Benicio54/Tucuman-respira/Informe_Técnico_Documentación/figuras/fig_22.jpeg

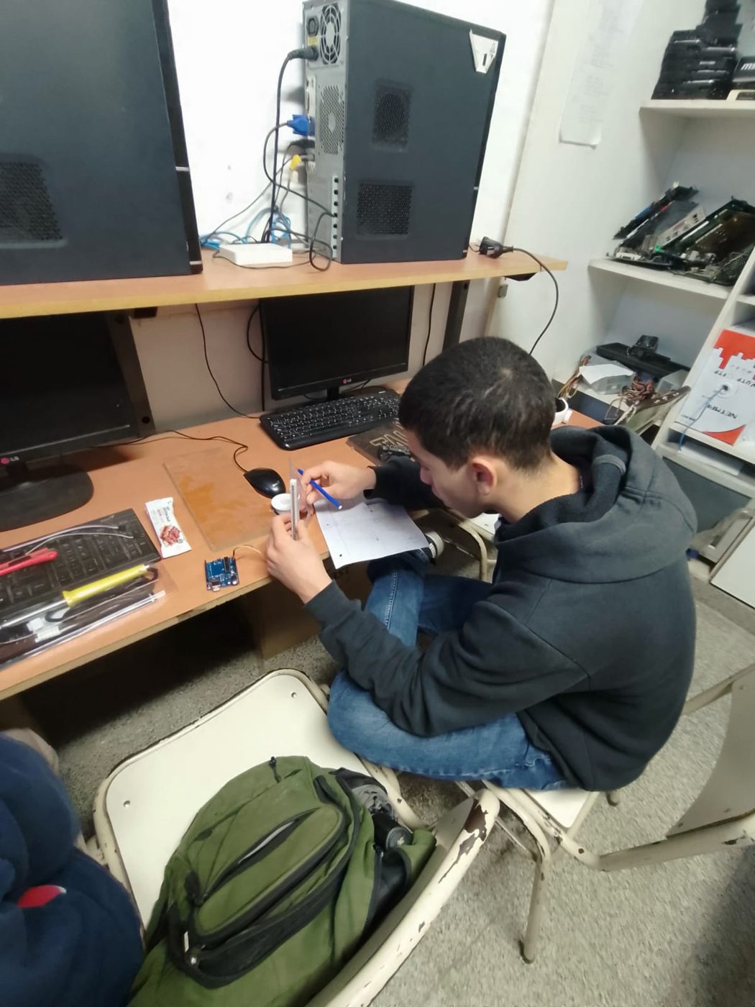
Informe_Técnico_Documentación/figuras/fig_22.jpeg
