Benicio54/Tucuman-respira/Diseño_Hardware/Diseño_Circuito/Diseño_Circuito.png

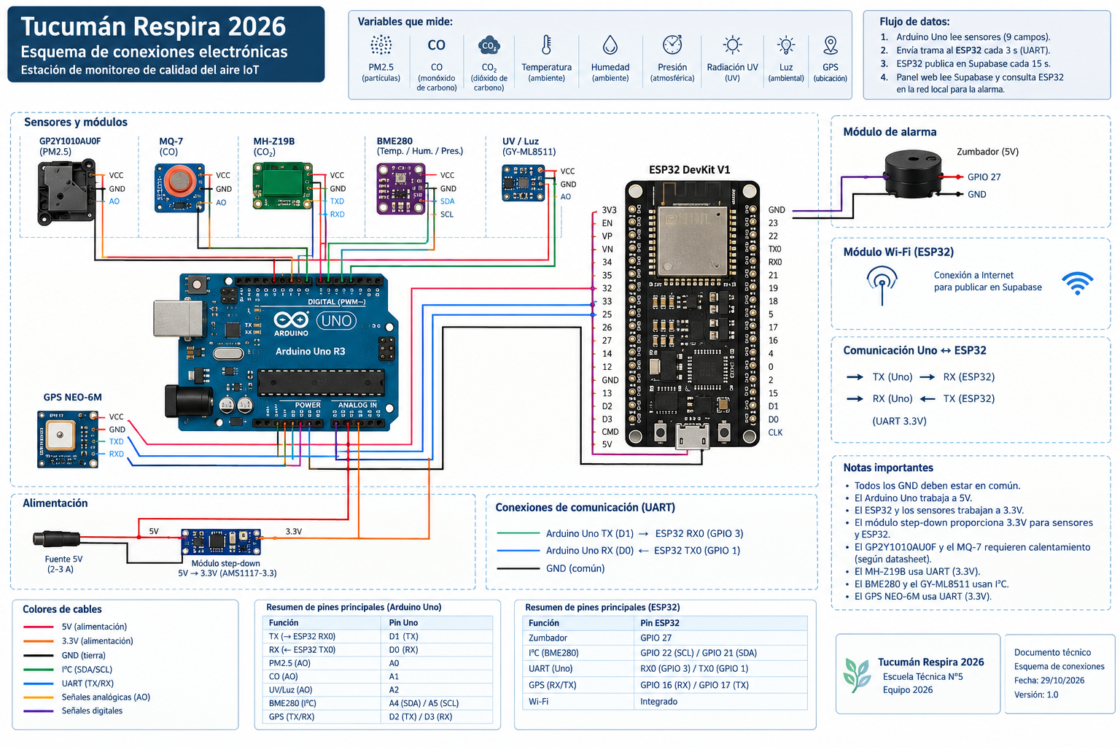
Diseño_Hardware/Diseño_Circuito/Diseño_Circuito.png
