Benicio54/Tucuman-respira/Informe_Técnico_Documentación/figuras/fig_03.jpeg

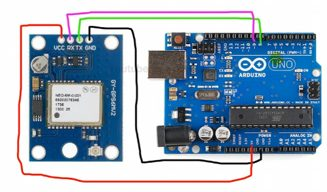
Informe_Técnico_Documentación/figuras/fig_03.jpeg
