Benicio54/Tucuman-respira/Informe_Técnico_Documentación/figuras/foto_14.jpeg

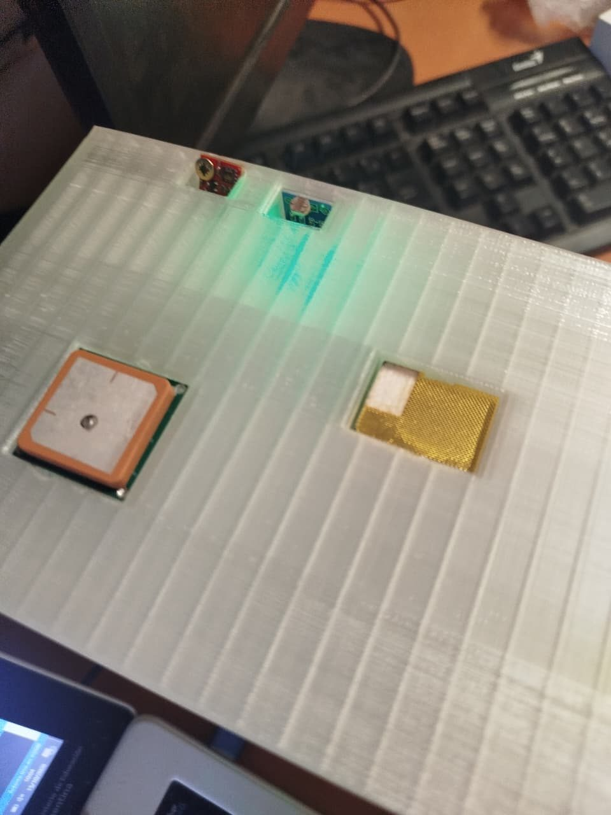
Informe_Técnico_Documentación/figuras/foto_14.jpeg
