Benicio54/Tucuman-respira/Informe_Técnico_Documentación/figuras/foto_42.jpeg

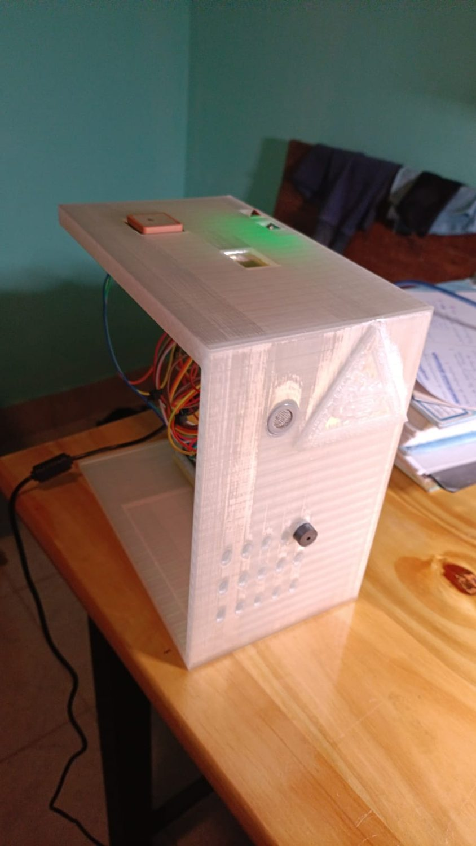
Informe_Técnico_Documentación/figuras/foto_42.jpeg
