Benicio54/Tucuman-respira/Diseño_Hardware/Diseño_Gabinete/Gabinete para tucuman respira.stl

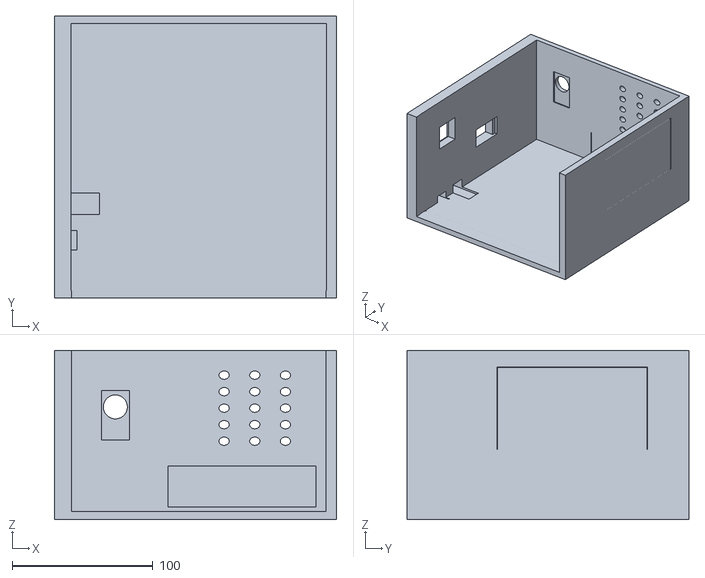
[picture p68: CAD file, 2026-10-29]
Diseño_Hardware/Diseño_Gabinete/Gabinete para tucuman respira.stl
200.0 x 200.0 x 120.0
