Benicio54/Tucuman-respira/(commit log)

2026-10-18 Primera subida de la Estación Climática: app web e informes
2026-10-18 Mover archivos web a la raíz para GitHub Pages
2026-10-18 Eliminar configuracion previa de actions
2026-10-18 Añadir archivos de la App-Web a la carpeta docs para GitHub Pages
2026-10-18 Actualización general de la estación climática y app web
2026-10-20 Actualización del código de la estación climática
2026-10-29 Actualización de informes y diseños
